ARK-Electronics/ARK_GPS/Hardware/Rev 3/ARK GPS Rev 3 BOM.xlsx

LibRef | Designator | Quantity | Manufacturer | Mfr Part Number | Comment | Mfr Part Description | Footprint | Supplier | Supplier Part Number
31085 | ANT1 | 1 | Linx Technologies Inc. | ANT-GNSSCP-TH18L1 | ANT-GNSSCP-TH18L1 | RF ANT GNSS PATCH L1 18X18 PIN | ANT-GNSSCP-TH18L1 | Digi-Key | 343-ANT-GNSSCP-TH18L1-ND
30303 | C1, C2, C12, C14, C15, C17, C21, C22, C24, C26, C28, C29 | 12 | Samsung Electro-Mechanics | CL05A104KP5NNNC | 0.1uF | CAP CER 0.1uF ±10% 10V X5R 0402 (1005 Metric) | CAP 0402/1005 | Digi-Key | 1276-1022-1-ND
30652 | C3, C4, C5, C6, C13, C31 | 6 | Samsung Electro-Mechanics | CL05A105KP5NNNC | 1uF | CAP CER 1uF ±10% 10V X5R 0402 (1005 Metric) | CAP 0402/1005 | Digi-Key | 1276-1076-1-ND
30418 | C7, C8, C9, C10 | 4 | Samsung Electro-Mechanics | CL05A106MP8NUB8 | 10uF | CAP CER 10uF ±20% 10V X5R 0402 (1005 Metric) | CAP 0402/1005 | Digi-Key | 1276-6830-1-ND
30018 | C11, C19 | 2 | Samsung | CL05B103KA5NNNC | 10nF | CAP CER 10000pF ±10% 25V X7R 0402 (1005 Metric) | CAP 0402/1005 | Digi-Key | 1276-1057-1-ND
31092 | C16 | 1 | Elna America | DSK-3R3H224U-HL | DCK-3R3E224U-E | CAP 220 mF -20%, +80% 3.3V Coin, Wide Terminals - Opposite Sides | DSK-3R3H224U-HL | Digi-Key | 604-1020-2-ND
30151 | C18, C20, C23 | 3 | Murata | GRM155R61A225ME95D | 2.2uF | CAP CER 2.2uF ±20% 10V X5R 0402 (1005 Metric) | CAP 0402/1005 | Digi-Key | 490-10452-2-ND
30302 | C25 | 1 | TDK Corporation | C1005X5R0J475K050BC | 4.7uF | CAP CER 4.7uF ±10% 6.3V X5R 0402 (1005 Metric) | CAP 0402/1005 | Digi-Key | 445-5947-1-ND
30502 | C27 | 1 | Samsung Electro-Mechanics | CL05C101JB5NNNC | 100pF | CAP CER 100pF ±5% 50V NPO 0402 (1005 Metric) | CAP 0402/1005 | Digi-Key | 1276-1025-1-ND
30011 | C30 | 1 | Murata | GRM155R71H102JA01J | 1000pF | CAP CER 1000pF ±5% 50V X7R 0402 (1005 Metric) | CAP 0402/1005 | Digi-Key | 490-6349-1-ND
30498 | C32 | 1 | Samsung Electro-Mechanics | CL05C121JB5NNNC | 120pF | CAP CER 120pF ±5% 50V NPO 0402 (1005 Metric) | CAP 0402/1005 | Digi-Key | 1276-1640-1-ND
30765 | D1 | 1 | Nexperia USA Inc. | PESD1CAN-UX | PESD1CAN-UX | TVS DIODE 24V 50V SC70-3 | SOT65P210X110-3N | Digi-Key | 1727-1306-1-ND
30943 | D2, D11 | 2 | Lite-On Inc. | LTST-C190KRKT | LTST-C190KRKT | LED RED CLEAR CHIP SMD | LTST-C191TBKT | Digi-Key | 160-1436-2-ND
30059 | D3 | 1 | Lite-On Inc. | LTST-C191TBKT | LTST-C191TBKT | LED BLUE CLEAR 0603 SMD | LTST-C191TBKT | Digi-Key | 160-1647-1-ND
30166 | D4, D5, D6, D7 | 4 | ON Semiconductor | ESD9C3.3ST5G | TVS Diode | TVS DIODE 3.3VWM SOD923 | SOD-923 | Digi-Key | ESD9C3.3ST5GOSCT-ND
30022 | D8 | 1 | Nexperia USA Inc. | BAT54J,115 | BAT54J,115 | DIODE SCHOTTKY 30V 200MA SOD323F | SOD323 | Digi-Key | 1727-4818-6-ND
30628 | D9, D10 | 2 | Lite-On Inc. | LTST-C191KGKT | LTST-C191KGKT | Green 571nm LED Indication - Discrete 2V 0603 (1608 Metric) | LTST-C191TBKT | Digi-Key | 160-1446-1-ND
30001 | FL1 | 1 | Taiyo Yuden | F6QA1G582H2JM-J | F6QA1G582H2JM-J | FILTER SAW GPS+GLONASS+COMPASS | F6QA1G582H2JM-J | Digi-Key | 587-3990-1-ND
30106 | J1, J2 | 2 | JST Sales America Inc. | SM04B-GHS-TB(LF)(SN)- | SM04B-GHS | CONN HEADER GH SIDE 4POS 1.25MM | SM04B-GHS | Digi-Key | 455-1566-1-ND
30085 | J3 | 1 | JST Sales America Inc. | SM06B-SRSS-TB(LF)(SN) | SM06B-SRSS-TB(LF)(SN) | CONN HEADER SH 6POS SIDE 1MM TIN | SM06B-SRSS-TB(LF)(SN) | Digi-Key | 455-1806-1-ND
30947 | L1 | 1 | Murata Electronics | LQW15AN6N8G80D | 6.8nH | INDUCTOR 6.8nH ±2% 1.45A 0402 (1005 Metric) | Ind 0402/1005 | Digi-Key | 490-14714-2-ND
31093 | Q1, Q2, Q3 | 3 | Nexperia USA Inc. | PMV130ENEAR | PMV130ENEAR | MOSFET N-CH 40V 2.1A TO236AB | SOT23 DIODES | Digi-Key | 1727-2299-2-ND
30956 | R1 | 1 | Stackpole Electronics Inc | RMCF0603FT120R | 120 | RES 120 Ohm ±1% 1/10W 0603 (1608 Metric) | RES603L | Digi-Key | RMCF0603FT120RTR-ND
30333 | R2, R3, R7, R14, R15, R16, R20, R24, R25 | 9 | Yageo | AC0402JR-07100KL | 100K | RES 100K Ohm ±5% 1/16W 0402 (1005 Metric) | RESC0402(1005)_N | Digi-Key | YAG3515CT-ND
30328 | R4, R5, R13 | 3 | Yageo | RC0402FR-07150RL | 150 | RES 150 Ohm ±1% 1/16W 0402 (1005 Metric) | RESC0402(1005)_N | Digi-Key | 311-150LRTR-ND
30207 | R6, R10, R11, R27, R28 | 5 | Yageo | RC0402FR-075K1L | 5.1K | RES 5.1K Ohm ±1% 1/16W 0402 (1005 Metric) | RESC0402(1005)_N | Digi-Key | 311-5.10KLRCT-ND
30838 | R8, R9 | 2 | Stackpole Electronics Inc | RMCF0402FT604R | 604 | RES 604 Ohm ±1% 1/16W 0402 (1005 Metric) | RESC0402(1005)_N | Digi-Key | RMCF0402FT604RCT-ND
30681 | R12, R19 | 2 | Yageo | RC0402FR-07330RL | 330 | RES 330 Ohm ±1% 1/16W 0402 (1005 Metric) | RESC0402(1005)_N | Digi-Key | 311-330LRCT-ND
30327 | R18, R21, R23 | 3 | Yageo | AC0402JR-070RL | 0 | RES 0 Ohm Jumper 1/16W 0402 (1005 Metric) | RESC0402(1005)_N | Digi-Key | 311-0.0LBCT-ND
31020 | S1 | 1 | C&ampK | PTS 647 SK38 SMTR2 LFS | SW PUSHBUTTON | TACT 4.5 X 4.5, 3.8 MM H, 2.5N, | PTS 647 SK38 SMTR2 LFS | Digi-Key | PTS647SK38SMTR2LFSTR-ND
30093 | SP1 | 1 | Soberton Inc. | ST-03CH | ST-03CH | AUDIO MAGNETIC XDCR 4-6V SMD | ST-03CH | Digi-Key | 433-1007-1-ND
30095 | U1 | 1 | NXP USA Inc. | TJA1051TK/3,118 | TJA1051TK/3,118 | IC CAN TRANSEIVER HS 8HVSON | 8DFN_3x3 | Digi-Key | 568-8686-1-ND
30451 | U2, U10 | 2 | ON Semiconductor | NCV8705MT33TCG | NCV8705MT33TCG | IC REG LINEAR 3.3V 500MA 6WDFN | WDFN6 2x2, 0.65P | Digi-Key | NCV8705MT33TCGOSCT-ND
30951 | U3 | 1 | Texas Instruments | LM66100DCKR | LM66100 | IC OR CTRLR IDEAL DIODE SC70-6 | SOT65P210X110-6N | Digi-Key | 296-53541-2-ND
30801 | U4 | 1 | Bosch Sensortec | BMM150 | BMM150 | SENSOR FLIPCORE/HALL SPI 12WLCSP | XDCR_BMM150 | Digi-Key | 828-1044-1-ND
31012 | U5 | 1 | U-Blox | NEO-M9N-00B | NEO-M9N-00B | M9 STANDARD PRECISION GNSS MOD | NEO-D9S | Digi-Key | 672-NEO-M9N-00BTR-ND
30579 | U6 | 1 | STMicroelectronics | STM32F412CEU6 | STM32F412CEU6 | ARM® Cortex®-M4 STM32F4 Microcontroller IC 32-Bit 100MHz 512KB (512K x 8) FLASH 48-UFQFPN (7x7) | UFQFPN48 | Digi-Key | 497-18545-ND
31087 | U7 | 1 | IQD Frequency Products | LFSPXO072801REEL | LFSPXO072801REEL | XTAL OSC XO 8.0000MHZ HCMOS SMD | LFSPXO072801REEL | Digi-Key | 1923-1681-2-ND
31021 | U8 | 1 | TDK InvenSense | ICM-42688-P | ICM-42688-P | MOTION SENSOR | ICM-42688-P | Digi-Key | 1428-ICM-42688-PTR-ND
30798 | U9 | 1 | Bosch Sensortec | BMP388 | BMP388 | SENSOR PRESSURE ABS | BMP388 | Digi-Key | 828-1079-1-ND
31314 | U11 | 1 | Infineon Technologies | BGA824N6E6329XTSA1 | BGU8019X | IC AMP GALI 1.164-1.615GHZ TSNP6 | TSNP-6-2 | Digi-Key | 448-BGA824N6E6329XTSA1TR-ND
