ARK-Electronics/ARK_GPS/Case/Bottom Case Rev 1.1.stl

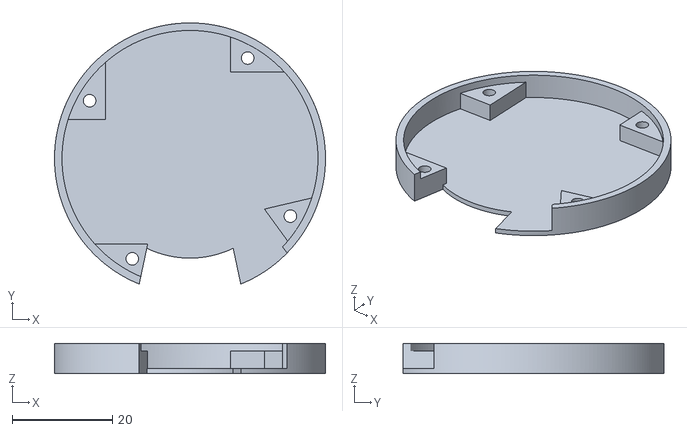
[picture p1: CAD file, 2023-07-10]
Case/Bottom Case Rev 1.1.stl
54.0 x 52.0 x 6.06
