ARK-Electronics/ARK_GPS/Case/Top Case Rev 1.stl

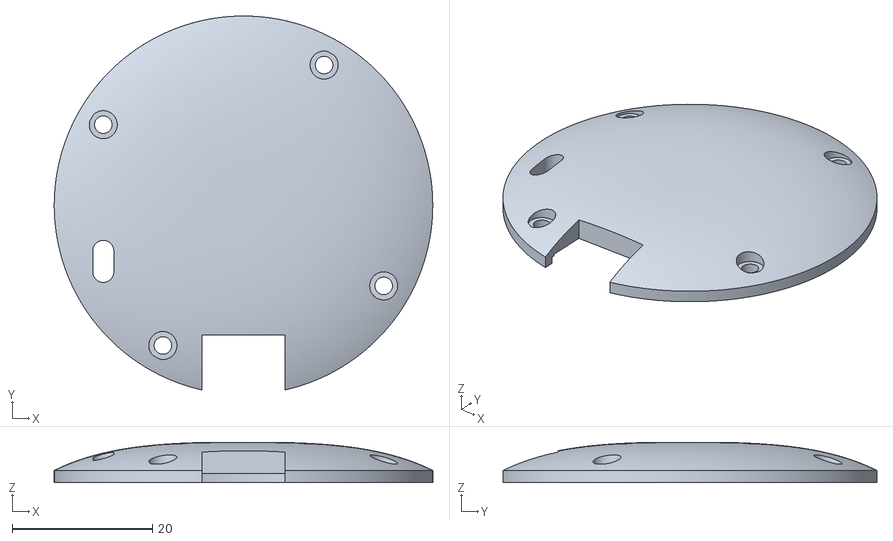
[picture p2: CAD file, 2021-06-14]
Case/Top Case Rev 1.stl
54.0 x 53.3 x 5.78
