ARK-Electronics/ARK_GPS/(list of files, cad)

Other CAD files:
Case/Bottom Case Rev 1.stl
