ARK-Electronics/ARK_GPS/Hardware/Rev 3/ARK GPS Rev 3 Schematic.PDF

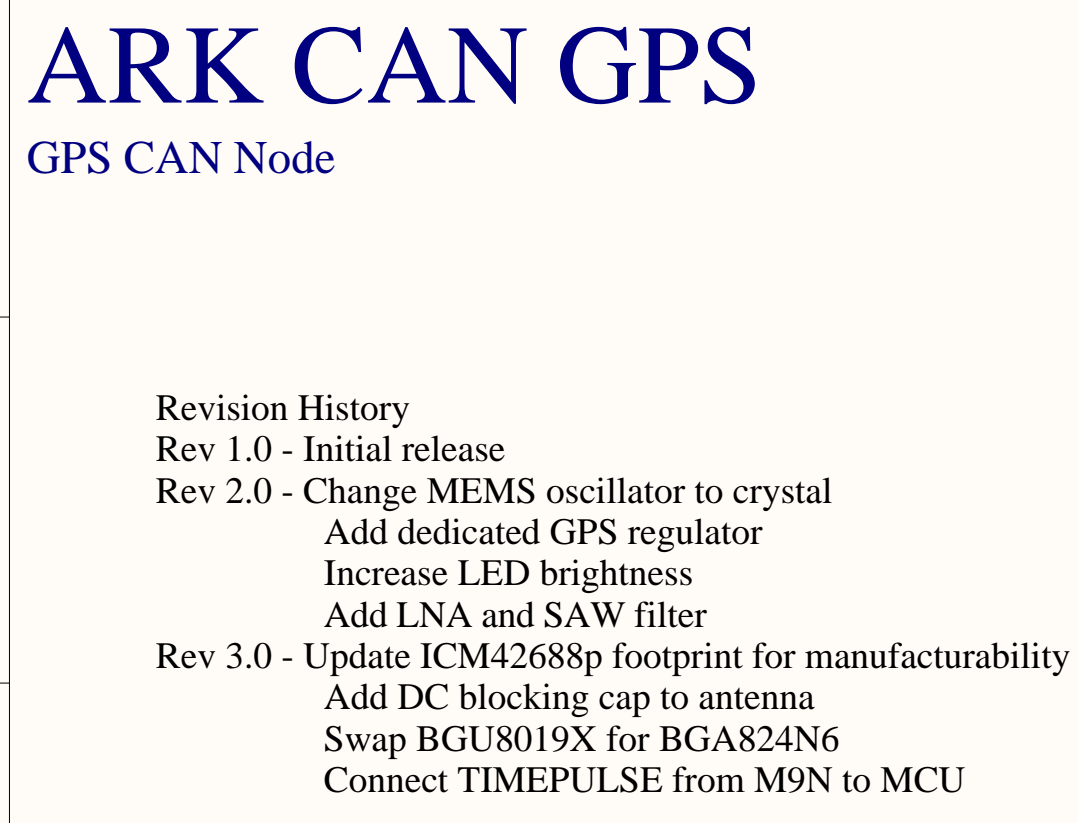
[picture p3: page 1]

Revision History
Rev 1.0 - Initial release
Rev 2.0 - Change MEMS oscillator to crystal

Add dedicated GPS regulator
Increase LED brightness
Add LNA and SAW filter

Rev 3.0 - Update ICM42688p footprint for manufacturability

Add DC blocking cap to antenna
Swap BGU8019X for BGA824N6
Connect TIMEPULSE from M9N to MCU

Revision: 3.0 | Variant: Production

Date: 5/17/2023 | Time: 5:05:21 PM | Size: LEGAL | Sheet 1 of 3

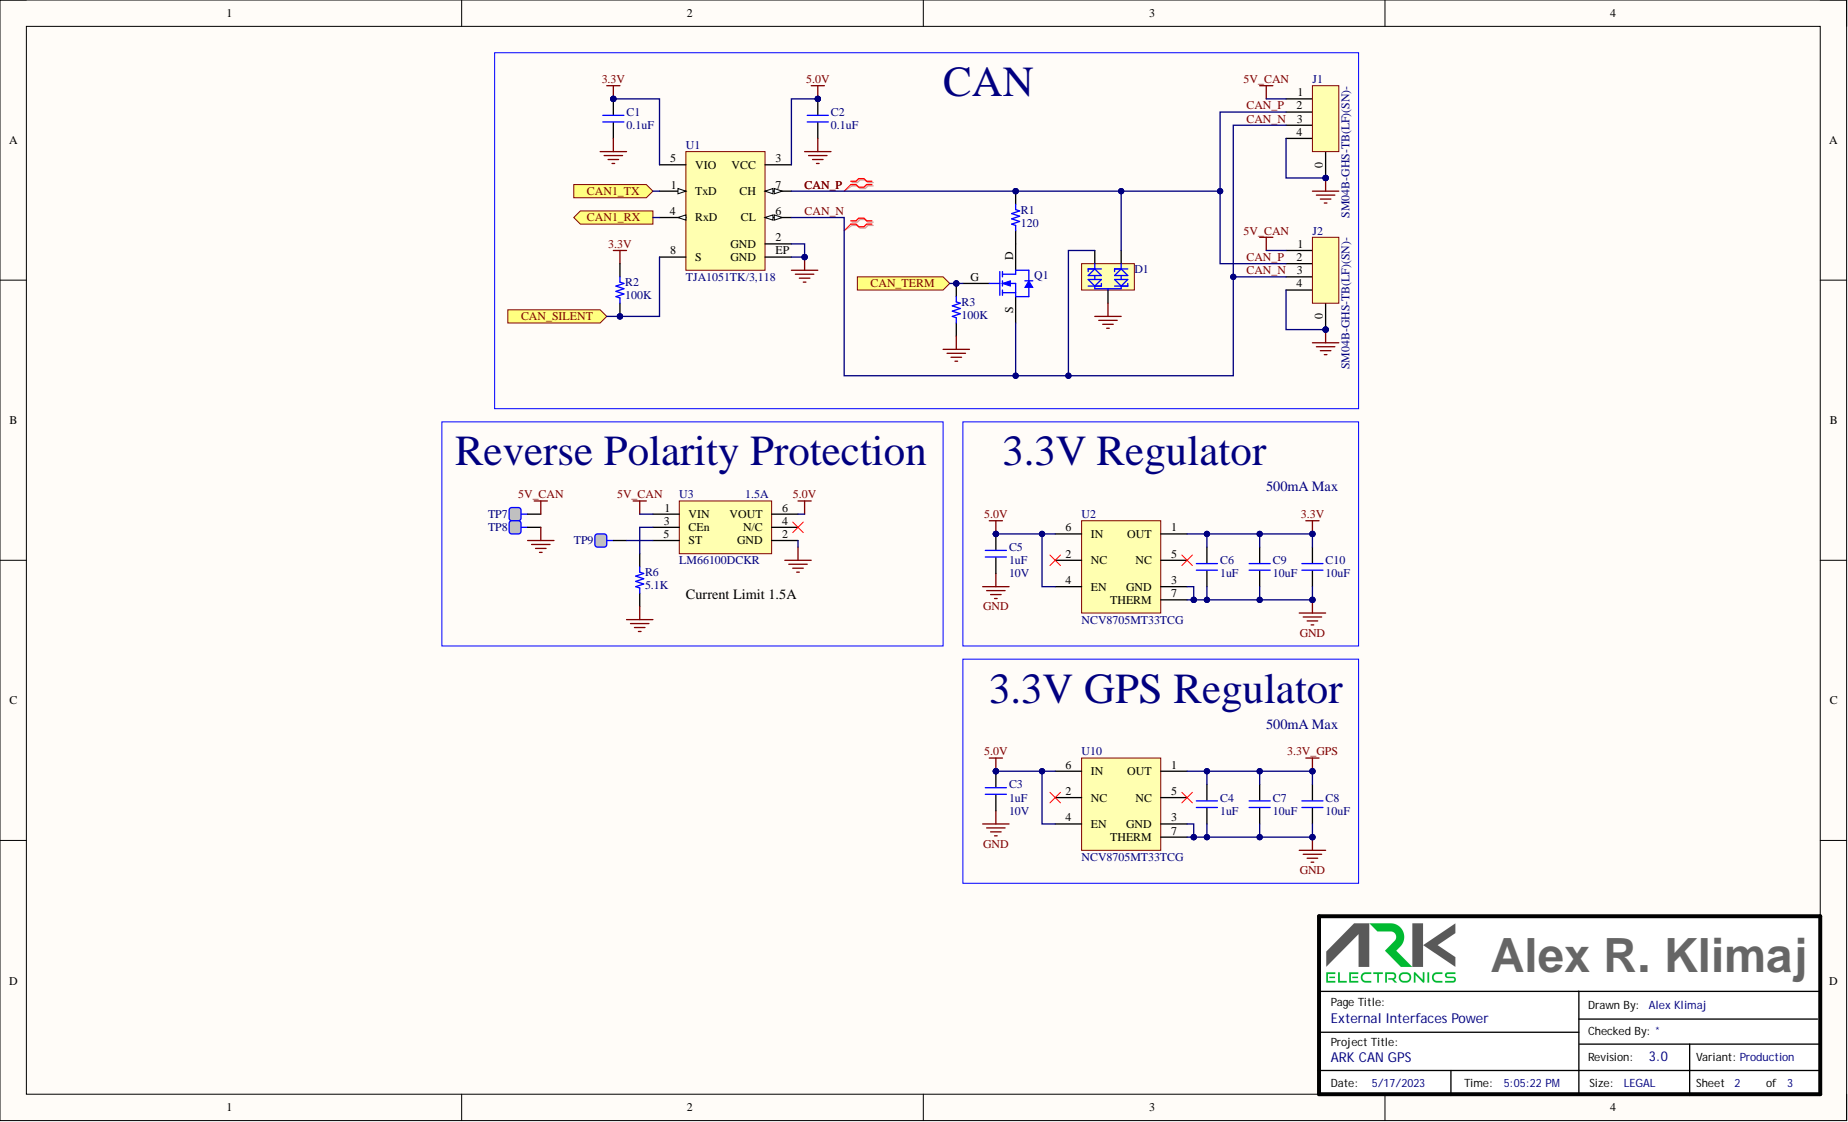
[picture p4: page 2]

SM04B-GHS-TB(LF)(SN)-

Revision: 3.0 | Variant: Production

Date: 5/17/2023 | Time: 5:05:22 PM | Size: LEGAL | Sheet 2 of 3

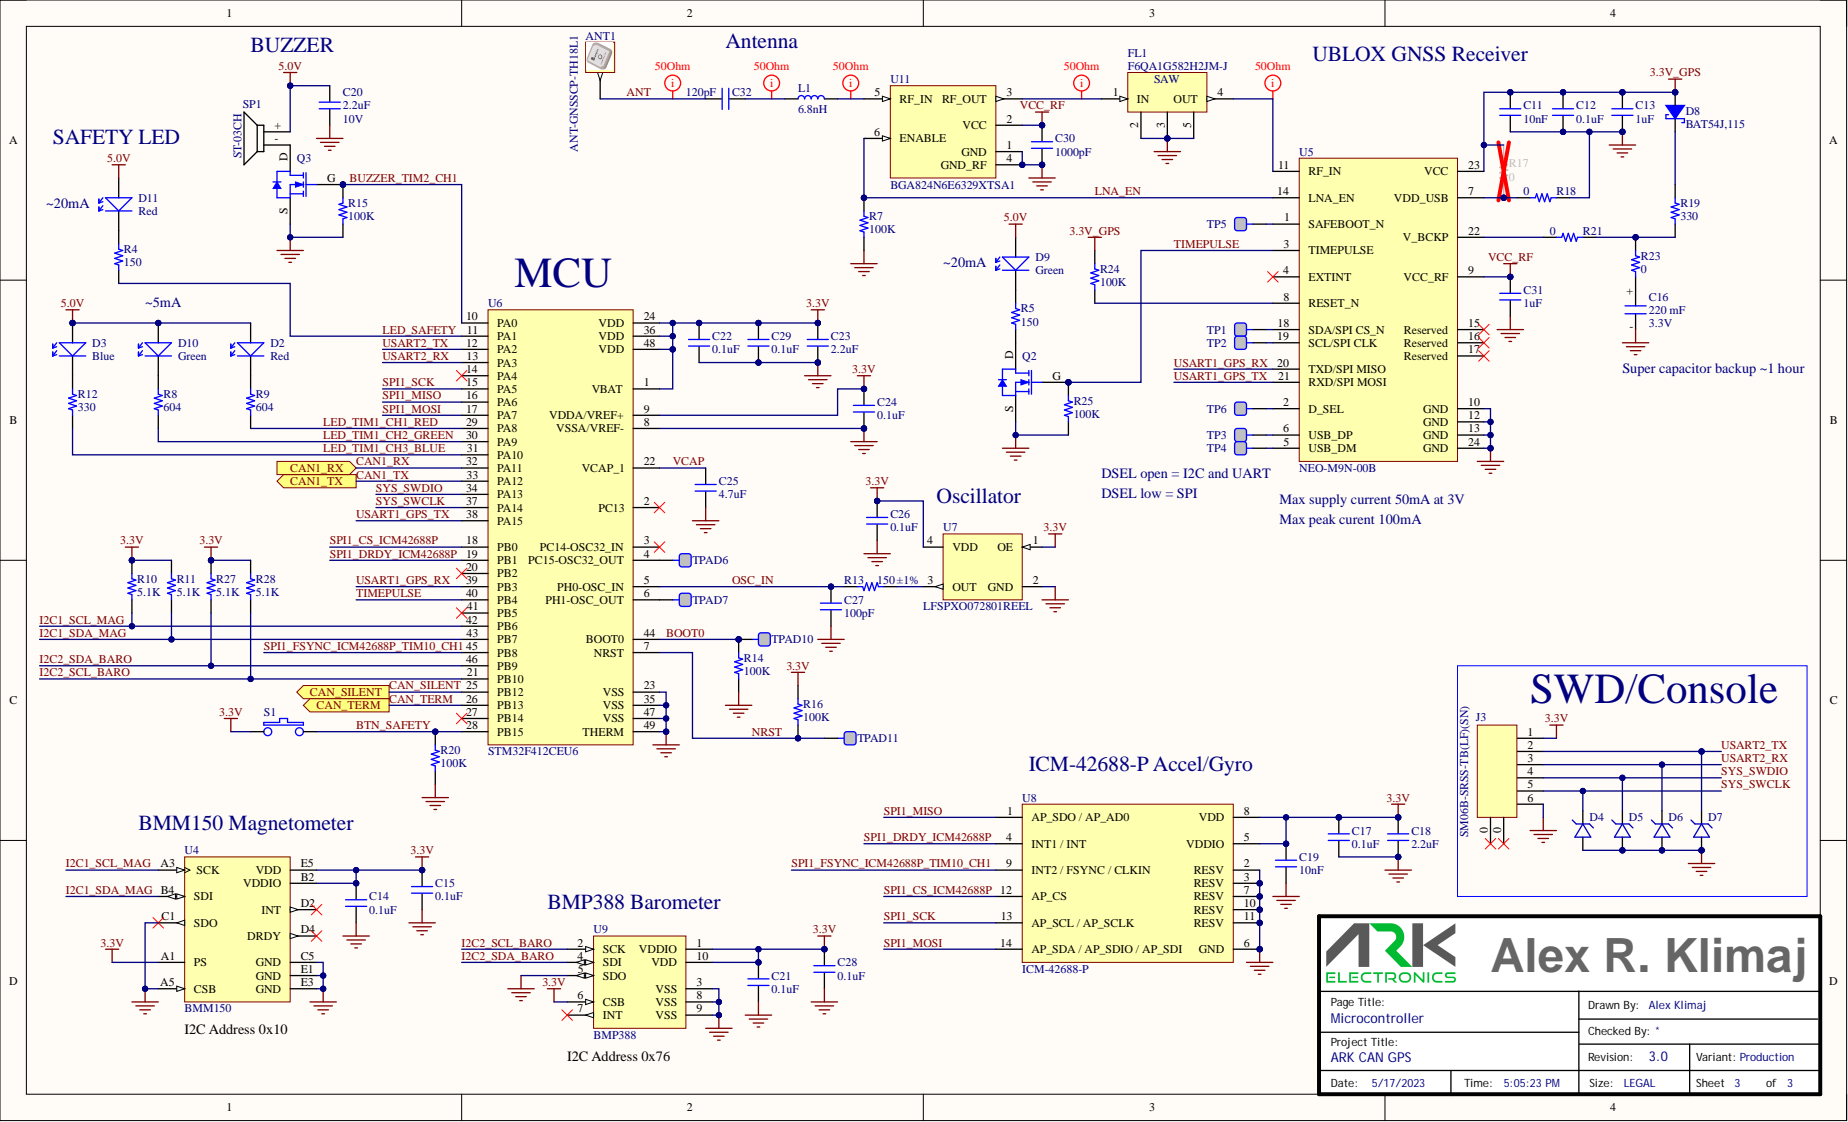
[picture p5: page 3]

GND GND_RF | 1 LNA_EN

Super capacitor backup ~1 hour

LED_TIM1_CH2_GREEN

DSEL open = I2C and UAR
DSEL low = SPI

Max supply current 50mA at 3V
Max peak curent 100mA

SM06B-SRSS-TB(LF)(SN) J3

AP_CS 12 AP_SCL / AP_SCLK 13 AP_SDA / AP_SDIO / AP_SDI 14 | 2

Revision : 3. | Variant : Producti o n

Date : 5/17/2023 | Time: 5:05:23 PM | Size : LEGA L | Sheet of
