ARK-Electronics/ARK_GPS/Hardware/Rev 1/ARK GPS Rev 1 Schematic.PDF

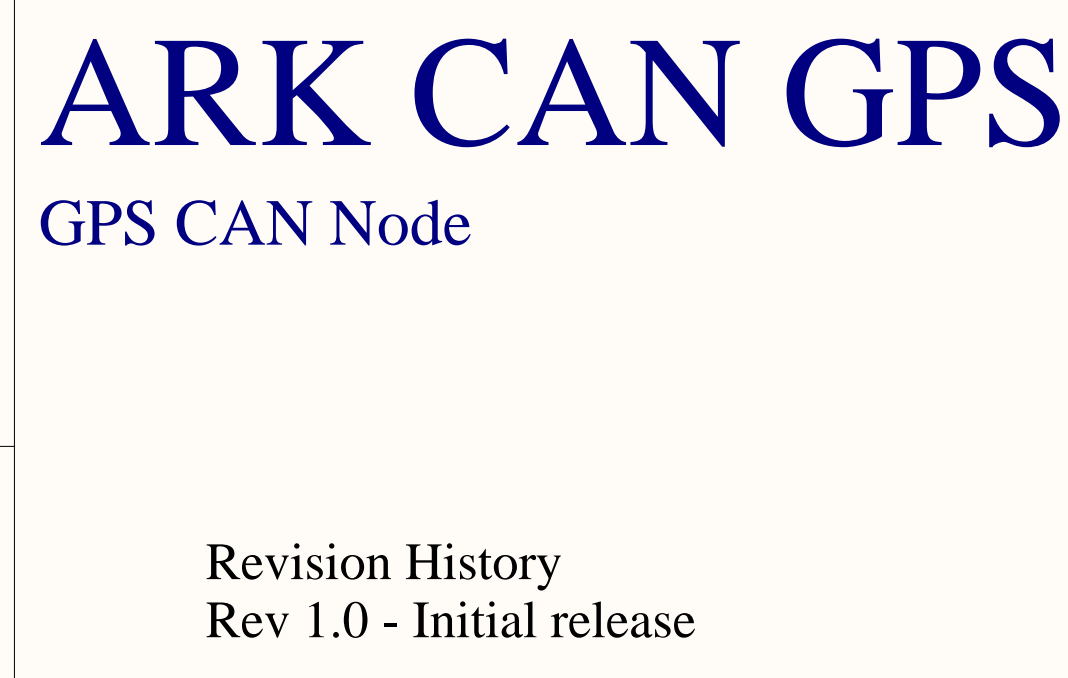
[picture p6: page 1]

Revision: 1.0 | Variant: Production

Date: 3/27/2021 | Time: 1:06:10 PM | Size: LEGAL | Sheet 1 of 3

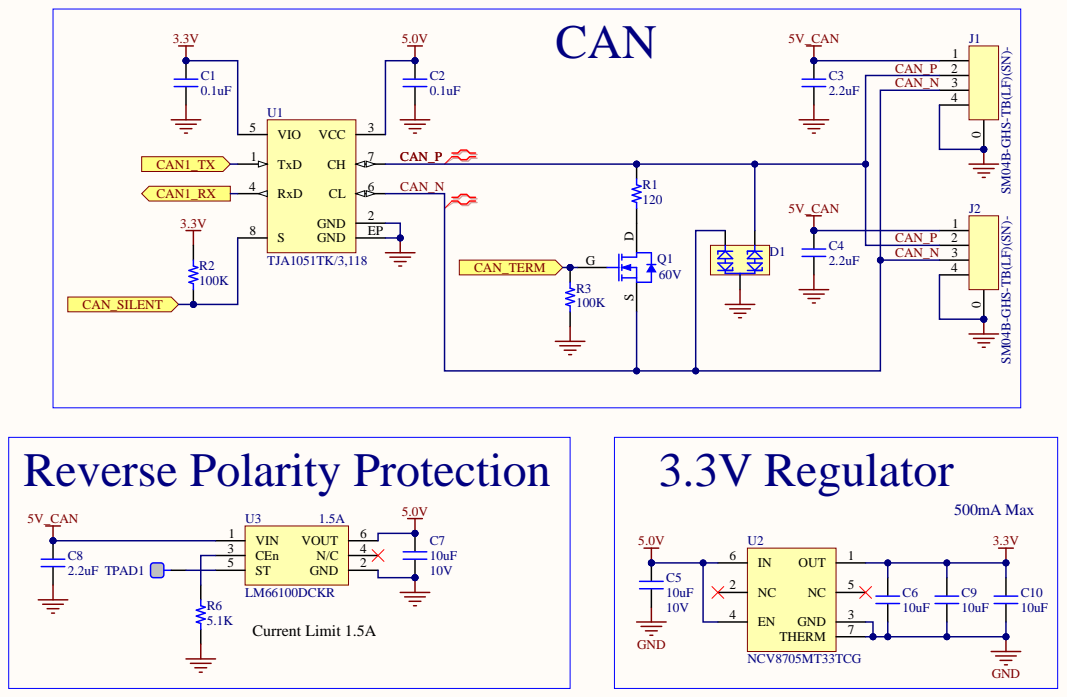
[picture p7: page 2]

SM04B-GHS-TB(LF)(SN)-

CAN_N | 3

Revision: 1.0 | Variant: Production

Date: 3/27/2021 | Time: 1:06:10 PM | Size: LEGAL | Sheet 2 of 3

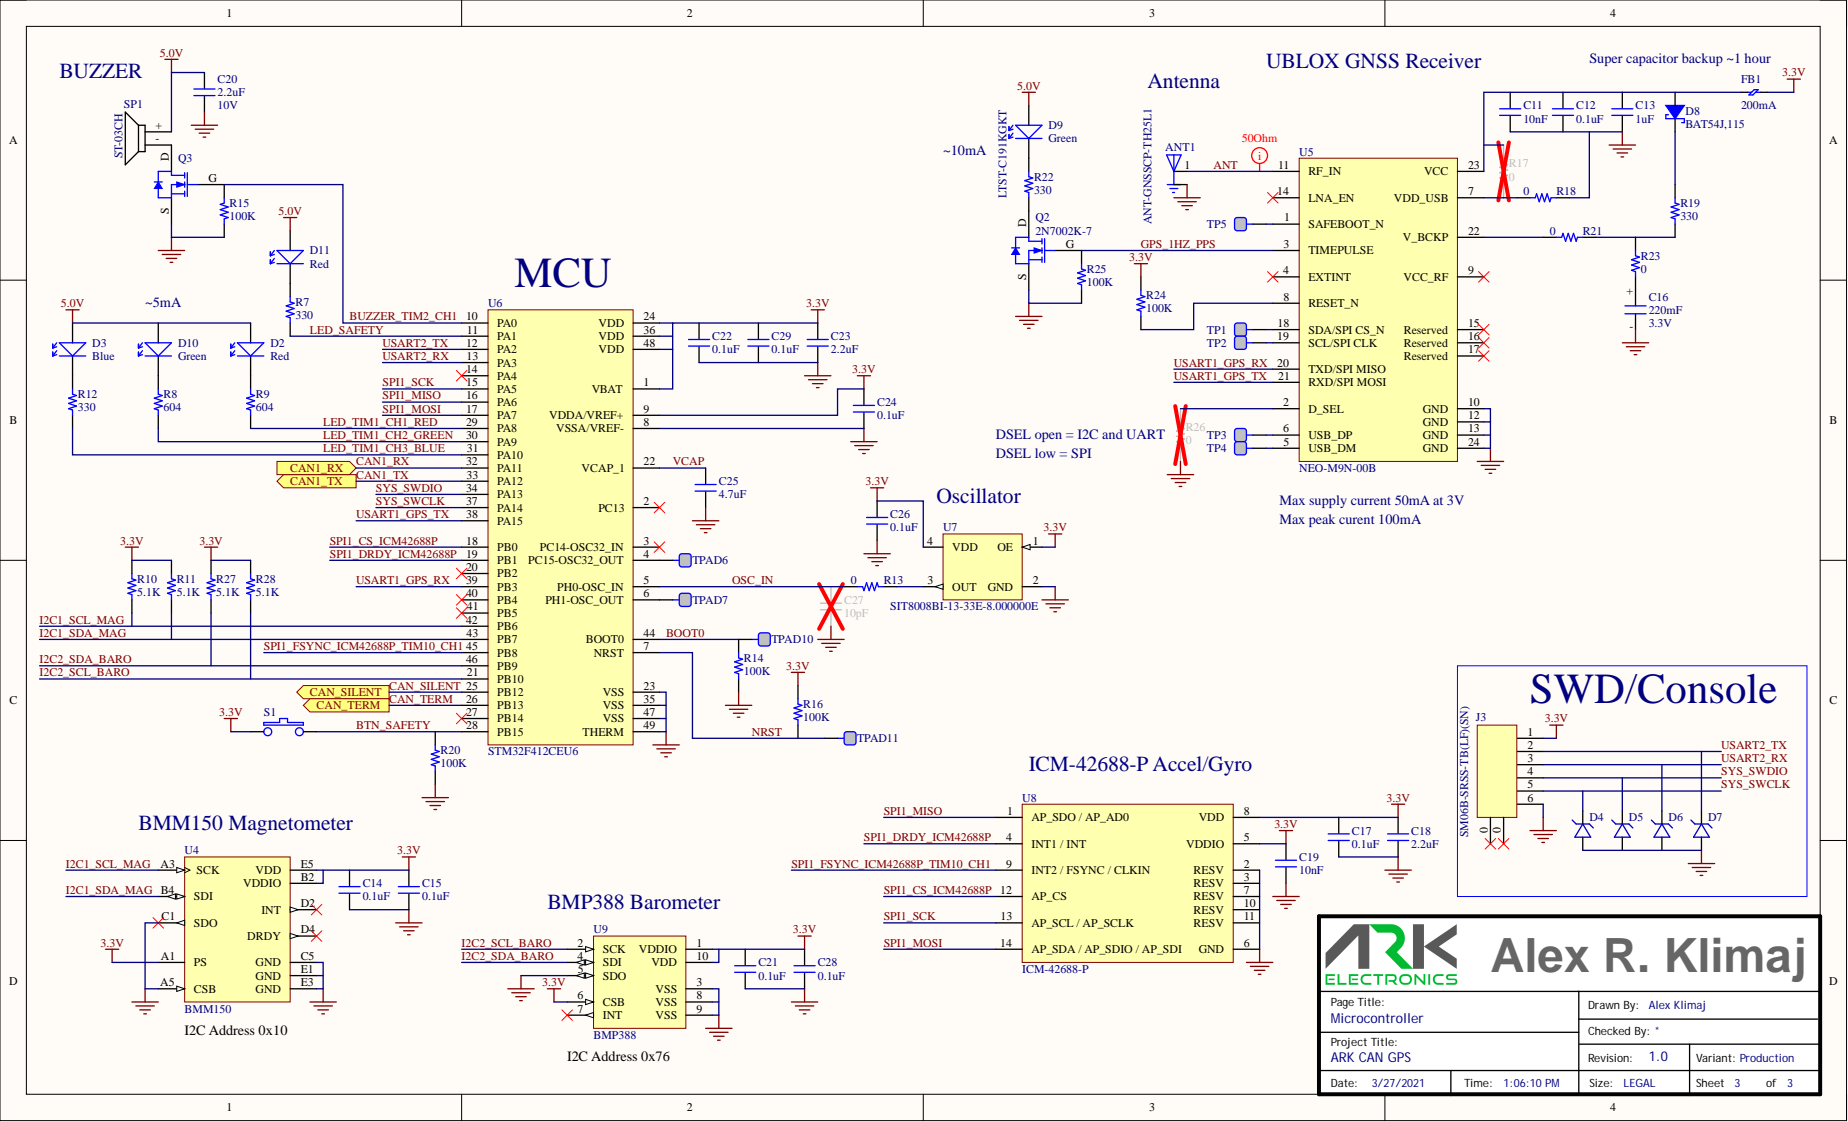
[picture p8: page 3]

Super capacitor backup ~1 hour

LED_SAFETY

DSEL open = I2C and UAR
DSEL low = SPI

Max supply current 50mA at 3V
Max peak curent 100mA

SM06B-SRSS-TB(LF)(SN) J3

Revision : 1. | Variant : Producti o n

Date : 3/27/2021 | Time: 1:06:10 PM | Size : LEGA L | Sheet of
