ARK-Electronics/ARK_GPS/Hardware/Rev 2/ARK GPS Rev 2 Schematic.PDF

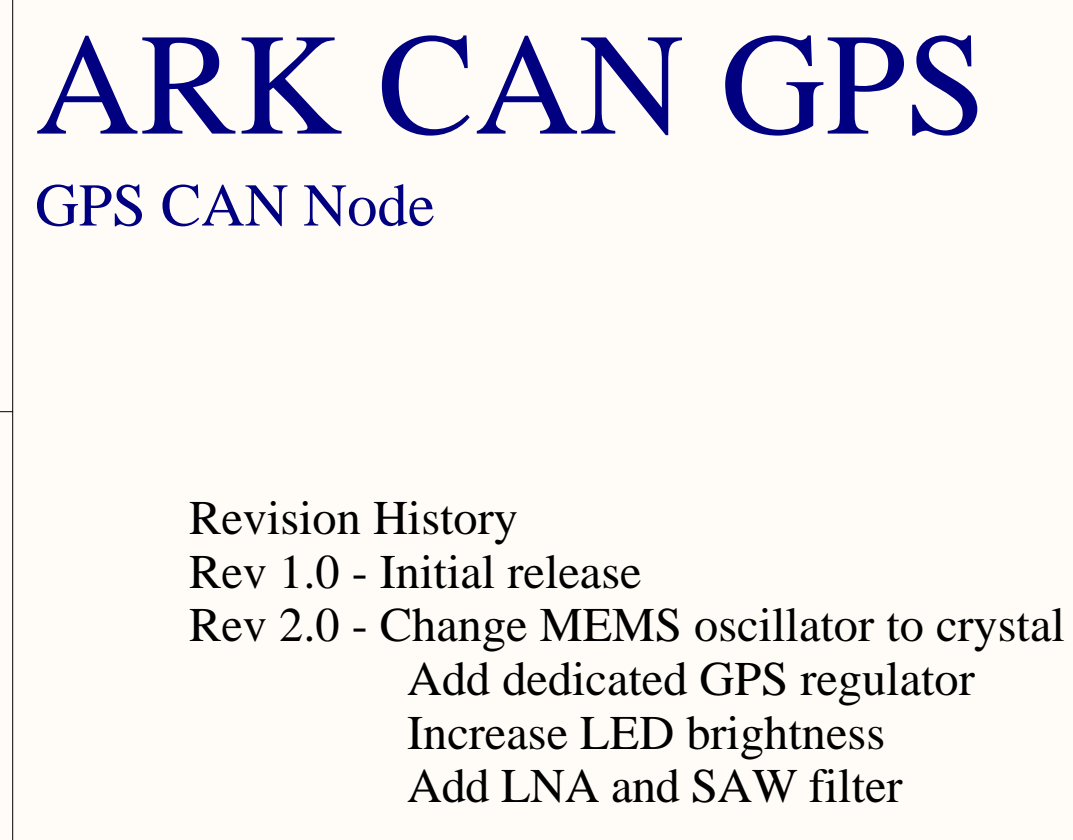
[picture p9: page 1]

Revision History
Rev 1.0 - Initial release
Rev 2.0 - Change MEMS oscillator to crystal

Add dedicated GPS regulator
Increase LED brightness
Add LNA and SAW filter

Revision: 2.0 | Variant: Production

Date: 5/26/2021 | Time: 9:45:13 AM | Size: LEGAL | Sheet 1 of 3

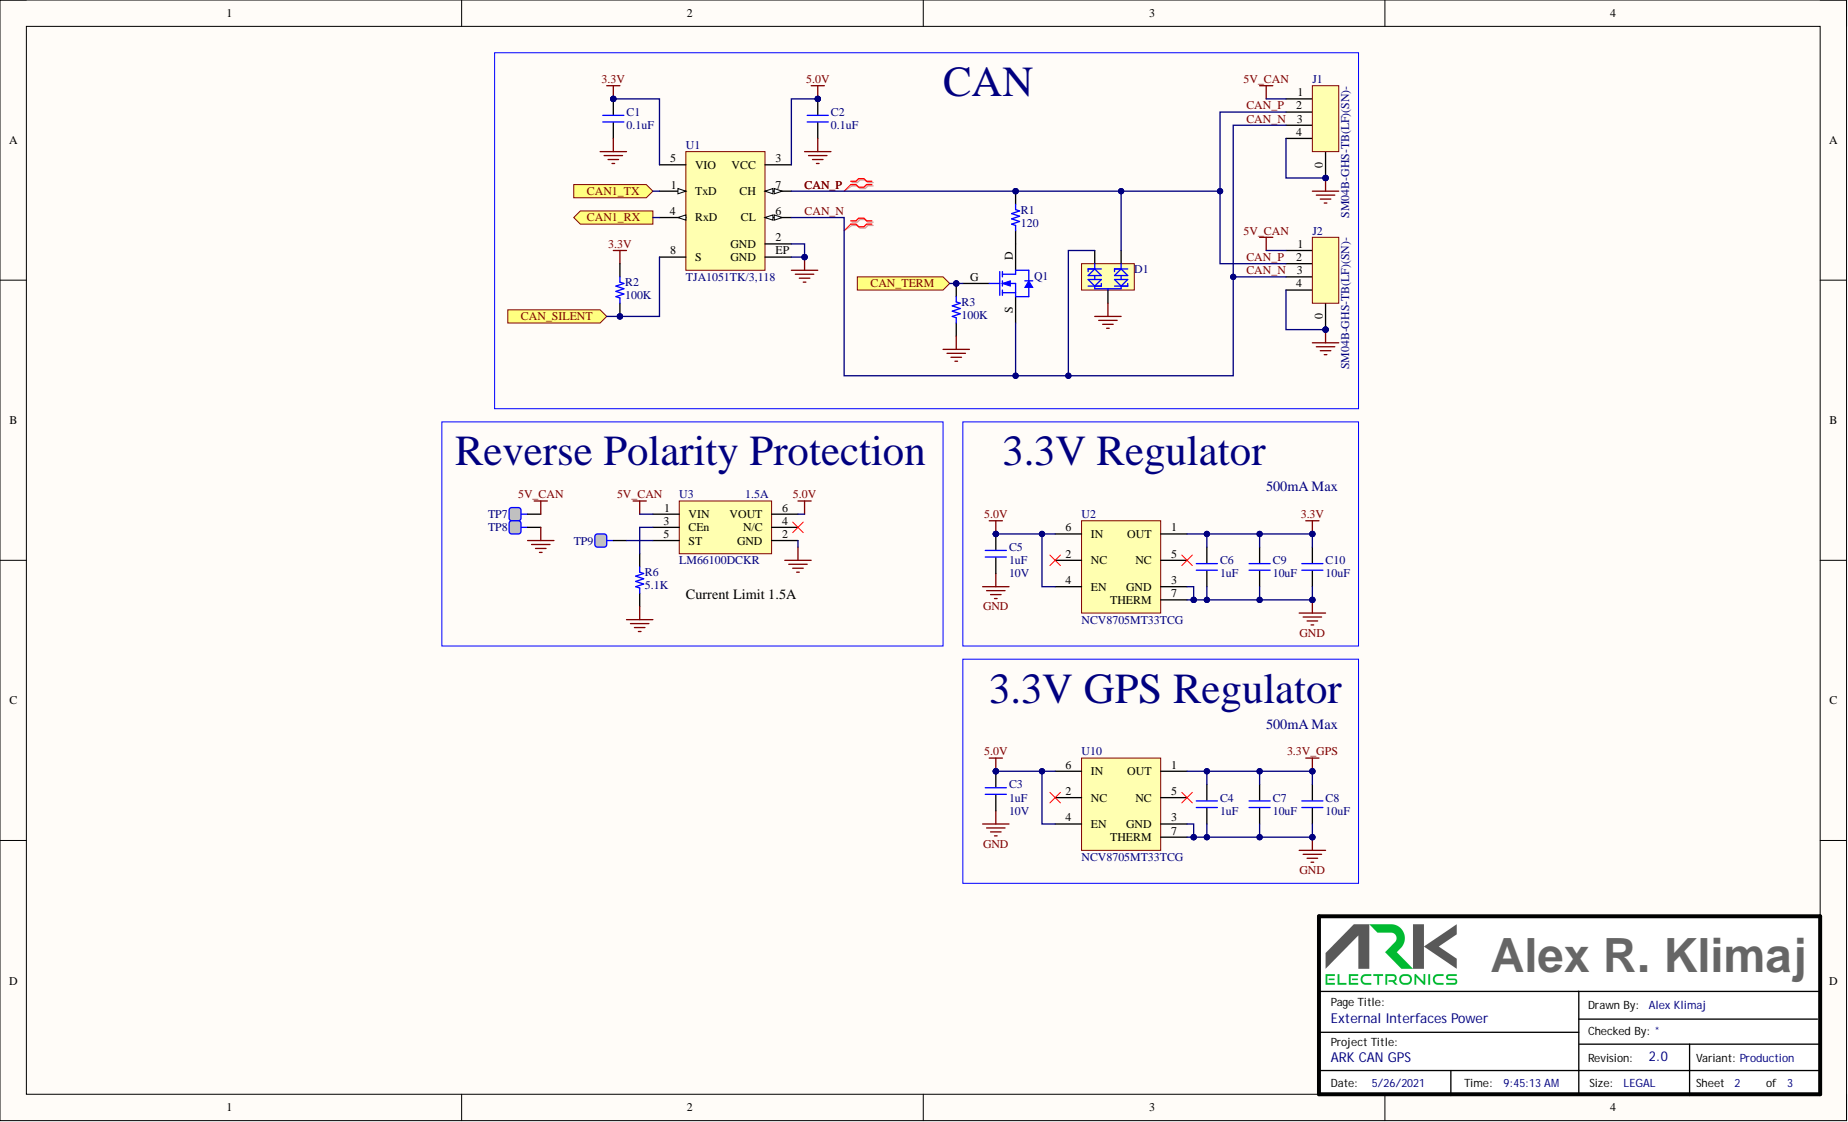
[picture p10: page 2]

SM04B-GHS-TB(LF)(SN)-

Revision: 2.0 | Variant: Production

Date: 5/26/2021 | Time: 9:45:13 AM | Size: LEGAL | Sheet 2 of 3

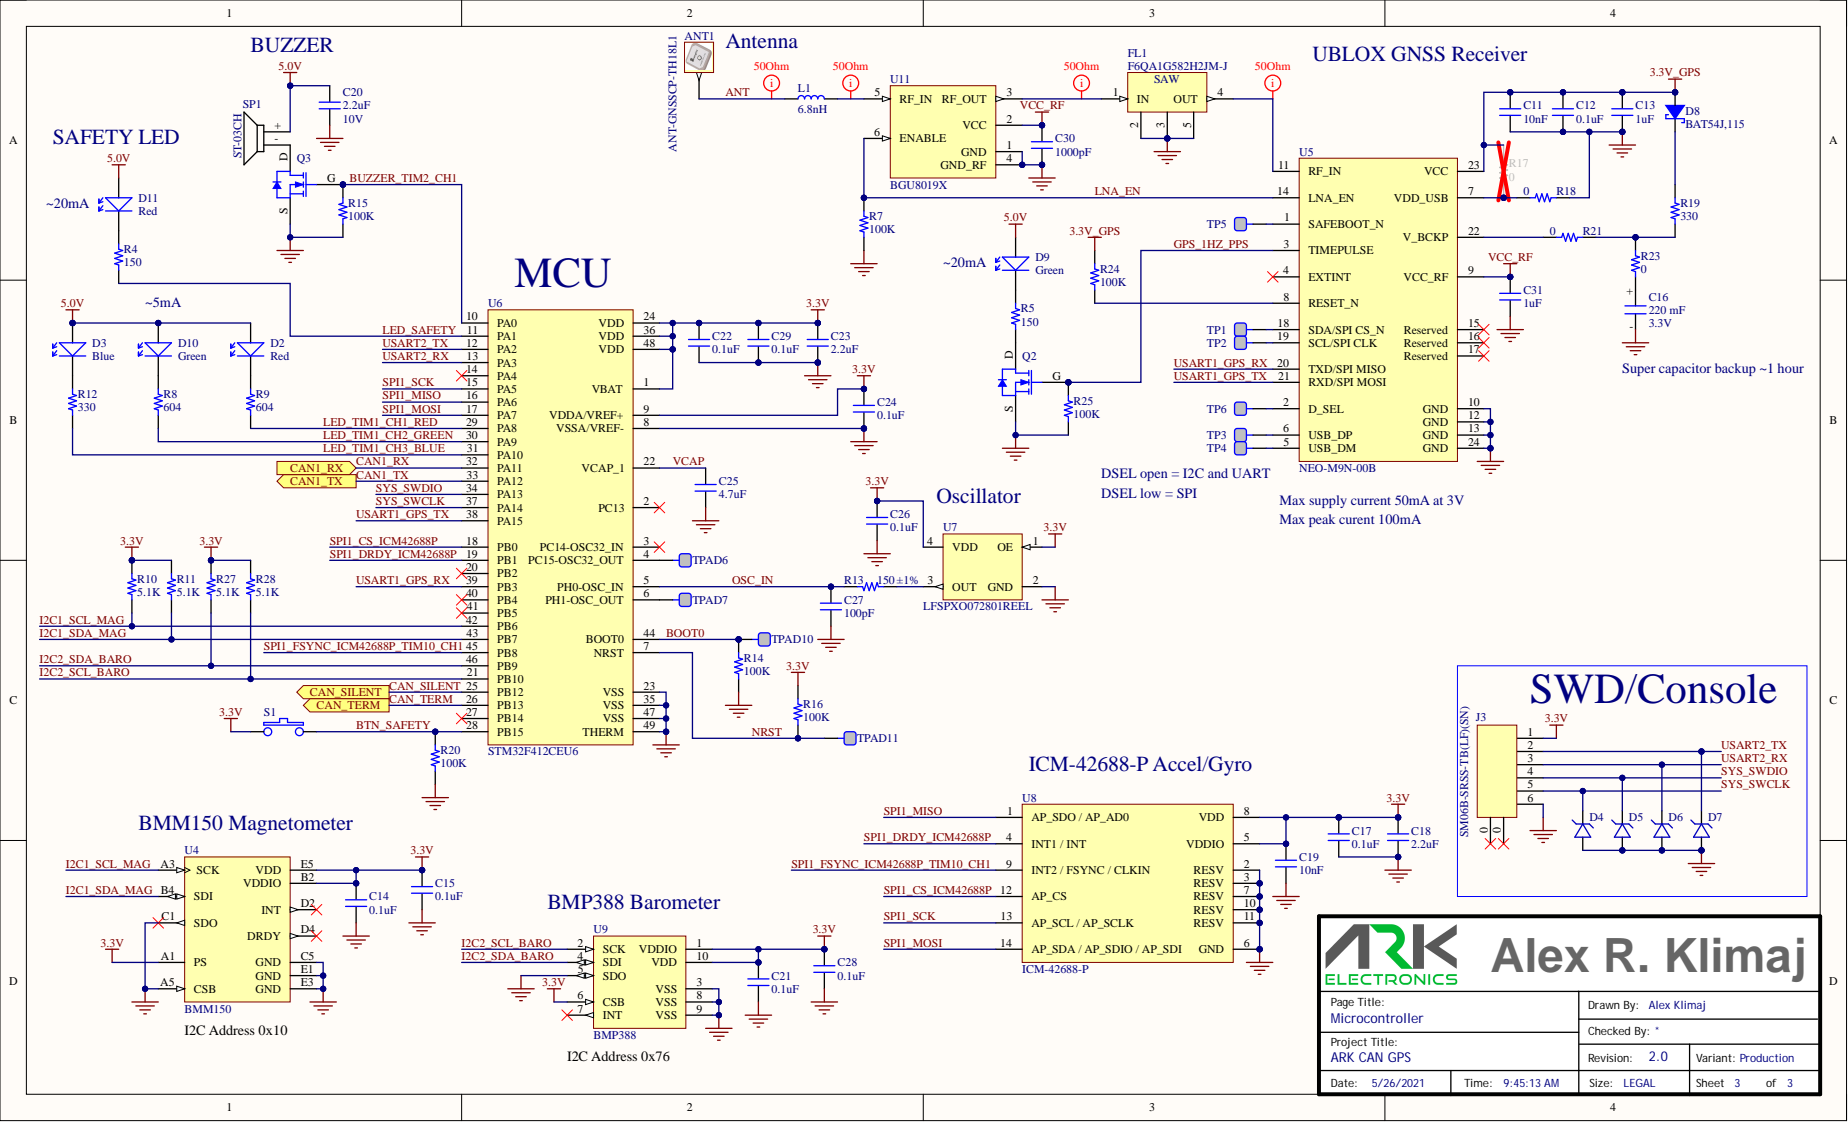
[picture p11: page 3]

GND GND_RF | 1 LNA_EN

Super capacitor backup ~1 hour

LED_TIM1_CH2_GREEN

DSEL open = I2C and UAR
DSEL low = SPI

Max supply current 50mA at 3V
Max peak curent 100mA

SM06B-SRSS-TB(LF)(SN) J3

AP_CS 12 AP_SCL / AP_SCLK 13 AP_SDA / AP_SDIO / AP_SDI 14 | 2

Revision : 2. | Variant : Producti o n

Date : 5/26/2021 | Time: 9:45:13 AM | Size : LEGA L | Sheet of
