ARK-Electronics/ARK_GPS/(commit log)

2021-06-14 Add ARK GPS Files
    [ARK GPS Rev 1 BOM.xlsx, ARK GPS Rev 2 BOM.xlsx, Bottom Case Rev 1.stl, Top Case Rev 1.stl]
2023-07-10 Create Bottom Case Rev 1.1.stl
    [Bottom Case Rev 1.1.stl]
2023-08-22 Add Rev 3 Files
    [ARK GPS Rev 3 BOM.xlsx]
